wyolum/BADGEr/fabricate/photos/DSCN1586.JPG

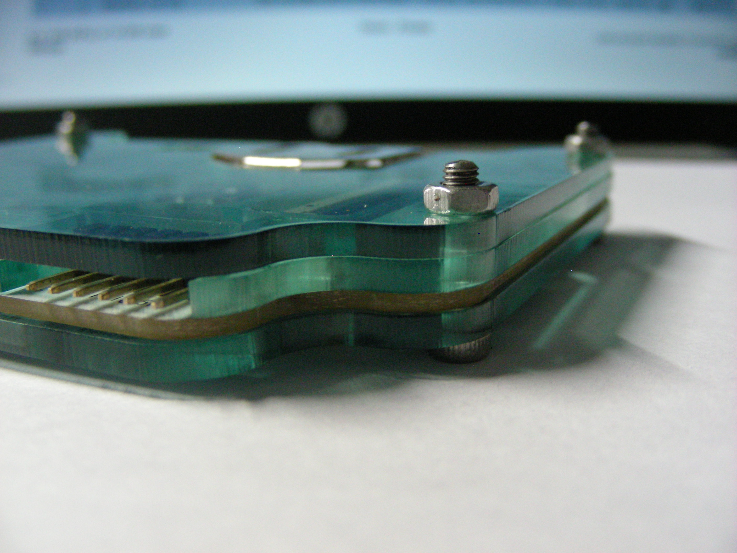
fabricate/photos/DSCN1586.JPG
