wyolum/BADGEr/fabricate/photos/DSCN1588.JPG

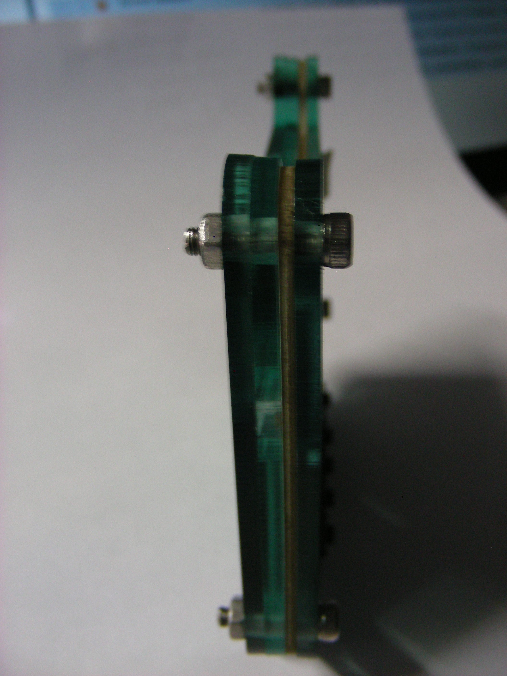
fabricate/photos/DSCN1588.JPG
