wyolum/BADGEr/README.md

BADGEr
======

EReader badge and shield
new version (v4.1) with minor mods to the front silk legend. No hardware changes from v4
