wyolum/BADGEr/Arduino/EPDV2/README.md

EPDV2
===

Electronic Paper Display libraries and examples
Updated for G2 COG driver
