wyolum/BADGEr/Kicad/BoM_BADGER_v41_Seeed.ods

Electronic Engineering BOM List
Product Name： OHSBadge
Version：V3.0
Issue Date：07/6/2013
Item No. (序号) | Reference Des (上件位置) | Qty (用量) | Catalog (分类） | Part_Description (规格描述) | Part_Value （元件值） | Part_Package （元件封装） | Manufacturers Name (使用厂牌名称) | Manufacturers Part No. (使用厂牌型号) | Distributors Name （供应商名称） | Distributors Part No. (供貨商型号) | Unit Price （单价） | Price Break To Use （价格分段的购买量） | Notes/Remark （备注）
Example（填写范例）
1 | BT1 | 1 | OTHER | RETAINER COIN CELL 24.5MM SMD | Coin Cell, Retainer, 24.5mm | CR2045_SMD | Keystone Electronics | 3008 | Digikey | 3008K-ND |  |  | http://www.digikey.com/product-detail/en/3008/3008K-ND/2137861
2 | BT2 | 1 | OTHER | BATTERY LITHIUM COIN 3V 24.5MM | Lithium, 3V, 650mAh, CR2450 | CR2450 | Panasonic - BSG | CR2450 | Digikey | P340-ND |  |  | http://www.digikey.com/product-detail/en/CR2450/P340-ND/447508
3 | C1,C11,C12,C14,C17,C18,C19,C20,C24,C25,C28,C30,C35 | 13 | Capacitor | 2.2u,16V, Y5V | CAP CER 2.2uF 16V Y5V 0805 | c_0805 | Samsung Electro-Mechanics America, Inc | CL21F225ZOFNNNE | Digikey | 1276-3016-1-ND |  |  | http://www.digikey.com/product-detail/en/CL21F225ZOFNNNE/1276-3016-1-ND/3891102
4 | C2,C3,C4,C5,C26,C27,C29,C31,C32,C33,C34 | 11 | Capacitor | 0.1u,16V, Y5V | CAP CER 0.1uF 16V Y5V 0805 | c_0805 | Kemet | C0805C104Z4VACTU | Digikey | 399-9159-1-ND |  |  | http://www.digikey.com/product-detail/en/C0805C104Z4VACTU/399-9159-1-ND/3522677
5 | C6,C9 | 2 | Capacitor | 22pF | CAP CER 22pF 16V 10% NP0 0603 | c_0805 | Kemet | C0603C220K4GACTU | Digikey | 399-9031-1-ND |  |  | http://www.digikey.com/product-detail/en/C0603C220K4GACTU/399-9031-1-ND/3522548
6 | C7 | 1 | Capacitor | 1u,16V, X7R | CAP CER 1uF 16V 10% X7R 0805 | c_0805 | Yageo | CC0805KKX7R7BB105 | Digikey | 311-1365-1-ND |  |  | http://www.digikey.com/product-detail/en/CC0805KKX7R7BB105/311-1365-1-ND/2103149
7 | C10 | 1 | Capacitor | 2.2u,10V, Y5V | CAP CER 2.2uF 10V Y5V 0805 | c_0805 | Murata Electronics North America | GRM21BF51A225ZA01L | Digikey | 490-1743-1-ND |  |  | http://www.digikey.com/product-detail/en/GRM21BF51A225ZA01L/490-1743-1-ND/587393
8 | C13 C15 C16 C22 C23 | 5 | Capacitor | 2.2u,25V, Y5V | CAP CER 2.2uF 25V Y5V 0805 | c_0805 | Samsung Electro-Mechanics America, Inc | CL21F225ZAFNNNE | Digikey | 1276-2874-1-ND |  |  | http://www.digikey.com/product-detail/en/CL21F225ZAFNNNE/1276-2874-1-ND/3890960
9 | C21 | 1 | Capacitor | 1u,10V, X7R | CAP CER 1uF 10V 20% X7R 0805 | c_0805 | Samsung Electro-Mechanics America, Inc | CL21B105MPFNNNE | Digikey | 1276-2933-1-ND |  |  | http://www.digikey.com/product-detail/en/CL21B105MPFNNNE/1276-2933-1-ND/3891019
10 | D1 | 1 | Diode | BAT54SW | DIODE SCHOTTKY 30V 200mA SC70 | SOT323 | NXP Semiconductors | BAT54SW,115 | Digikey | 568-1615-1-ND |  |  | http://www.digikey.com/product-detail/en/BAT54SW,115/568-1615-1-ND/763442
11 | D2 | 1 | Diode | DB2S20500L | DIODE SCHOTTKY 15V 200mA SSMINI2 | d_VMD2 | Panasonic Electronic Components - Semiconductor Products | DB2S20500L | Digikey | DB2S20500LCT-ND |  |  | http://www.digikey.com/product-detail/en/DB2S20500L/DB2S20500LCT-ND/2326091
12 | D3 | 1 | Diode | DEBUG | LED MINI TOPLED RED 630NM SMD | 2-SMD, J-Lead | OSRAM Opto Semiconductors Inc | LS M67K-J2L1-1-Z | Digikey | 475-2691-1-ND |  |  | http://www.digikey.com/product-detail/en/LS%20M67K-J2L1-1-Z/475-2691-1-ND/1938858
13 | J4 | 1 | Connector | ZIF-40-0.5 | CONN FPC/FFC 40POS .5MM HORZ SMD | ZIF-40-0.5-M | OSRAM Opto Semiconductors Inc | LG M67K-H1J2-24-Z | Digikey | 475-2730-1-ND |  |  | http://www.digikey.com/product-detail/en/LG%20M67K-H1J2-24-Z/475-2730-1-ND/1938897
14 | P3 | 1 | Connector | FTDI | CONN HEADER 6POS .100 R/A 30AU | Header_FTDI | FCI | 68016-106HLF | Digikey | 609-3313-ND |  |  | http://www.digikey.com/product-detail/en/68016-106HLF/609-3313-ND/1878482
15 | Q1 | 1 | Transistor | DMG2301U-7 | MOSFET P-CH 20V 2.5A SOT23 | SOT23-3 | Diodes Inc | DMG2301U-7 | Digikey | DMG2301U-7DICT-ND |  |  | http://www.digikey.com/product-detail/en/DMG2301U-7/DMG2301U-7DICT-ND/2179851
16 | Q2 Q4 Q5 Q6 | 4 | Transistor | 2N7002KW | MOSFET NCH 60V 310mA SOT323 | SOT323 | Fairchild Semiconductor | 2N7002KW | Digikey | 2N7002KWCT-ND |  |  | http://www.digikey.com/product-detail/en/2N7002KW/2N7002KWCT-ND/3907885
17 | Q3 Q7 | 2 | Transistor | BSS84W | MOSFET P-CH 50V 130mA SC70-3 | SOT323 | Diodes Inc | BSS84W-7-F | Digikey | BSS84W-FDICT-ND |  |  | http://www.digikey.com/product-detail/en/BSS84W-7-F/BSS84W-FDICT-ND/806569
18 | R1 | 1 | Resister | 33k, 5% | RES 33k OHM 1/8W 5% 0805 SMD | r_0805 | Yageo | RC0805JR-0733KL | Digikey | 311-33KARCT-ND |  |  | http://www.digikey.com/product-detail/en/RC0805JR-0733KL/311-33KARCT-ND/731261
19 | R4 R5 R6 R7 R8 R13 R16 | 7 | Resister | 10k, 5% | RES 10k OHM 1/8W 5% 0805 | r_0805 | Stackpole Electronics Inc | RMCF0805JT10K0 | Digikey | RMCF0805JT10K0CT-ND |  |  | http://www.digikey.com/product-detail/en/RMCF0805JT10K0/RMCF0805JT10K0CT-ND/1942577
20 | R9 | 1 | Resister | 2k, 5% | RES 2.0k OHM 1/8W 5% 0805 SMD | r_0805 | Yageo | RC0805JR-072KL | Digikey | 311-2.0KARCT-ND |  |  | http://www.digikey.com/product-detail/en/RC0805JR-072KL/311-2.0KARCT-ND/731215
21 | R10 R11 R12 | 3 | Resister | 100k, 5% | RES 100k OHM 1/8W 5% 0805 | r_0805 | Stackpole Electronics Inc | RMCF0805JT100K | Digikey | RMCF0805JT100KCT-ND |  |  | http://www.digikey.com/product-detail/en/RMCF0805JT100K/RMCF0805JT100KCT-ND/1942592
22 | R14 | 1 | Resister | 1k5, 5% | RES 1k5 OHM 1/8W 5% 0805 | r_0805 | Stackpole Electronics Inc | RMCF0805JT1K50 | Digikey | RMCF0805JT1K50CT-ND |  |  | http://www.digikey.com/product-detail/en/RMCF0805JT1K50/RMCF0805JT1K50CT-ND/1942560
23 | SD1 | 1 | Connector | Micro SD Card Socket | SD_CARD_MICRO | SD_Micro | ? | ? | seeed | ST-SD-006A |  |  | ?
24 | SW1 | 1 | OTHER | UP | SWITCH TACTILE SPST-NO 0.05A 12V | SW-PB | Diptronics Manufacturing Inc. | DTSM-62 | Seeed | --
25 | SW2 | 1 | OTHER | SEL | SWITCH TACTILE SPST-NO 0.05A 12V | SW-PB | Diptronics Manufacturing Inc. | DTSM-62 | Seeed | --
26 | SW3 | 1 | OTHER | DOWN | SWITCH TACTILE SPST-NO 0.05A 12V | SW-PB | Diptronics Manufacturing Inc. | DTSM-62 | Seeed | --
27 | SW4 | 1 | OTHER | RST | SWITCH TACTILE SPST-NO 0.05A 12V | SW-PB | Diptronics Manufacturing Inc. | DTSM-62 | Seeed | --
28 | SW5 | 1 | OTHER | MODE | SWITCH TACTILE SPST-NO 0.05A 12V | SW-PB | Diptronics Manufacturing Inc. | DTSM-62 | Seeed | --
 | SW6 | 1 | OTHER | SW_ON | Switch, Slide, SMD | SW_SLIDE_seeed | HC Brand (moralityele.com) | MS-12C02 | Seeed | --
29 | U1 | 1 | IC | MCP9700AT-E/TT | IC SENSOR THERMAL 2.3V SOT-23-3 | SOT23-3-Temp | Microchip Technology | MCP9700AT-E/TT | Digikey | MCP9700AT-E/TTCT-ND |  |  | http://www.digikey.com/product-detail/en/MCP9700AT-E%2FTT/MCP9700AT-E%2FTTCT-ND/3622388
30 | U2 | 1 | IC | ATMEGA328-AU-ND | IC MCU 8BIT 32KB FLASH 32TQFP | TQFP32 | Atmel | ATMEGA328-AU | Digikey | ATMEGA328-AU-ND |  |  | http://www.digikey.com/product-detail/en/ATMEGA328-AU/ATMEGA328-AU-ND/2271029
31 | U3 | 1 | IC | MCP1700T-33 | IC REG LDO 3.3V .25A SOT23-3 | SOT23 | Microchip Technology | MCP1700T-3302E/TT | Digikey | MCP1700T3302ETTCT-ND |  |  | http://www.digikey.com/product-detail/en/MCP1700T-3302E%2FTT/MCP1700T3302ETTCT-ND/652677
32 | U4 | 1 | IC | TXS0108 | IC 8BIT NON-INV TRANSLTR 20TSSOP | SO20L | Texas Instruments | TXS0108EPWR | Digikey | 296-23011-1-ND |  |  | http://www.digikey.com/product-detail/en/TXS0108EPWR/296-23011-1-ND/1775304
33 | U6 | 1 | IC | MCP1702T-50 | IC REG LDO 5V .25A SOT-23A | SOT23 | Microchip Technology | MCP1702T-5002E/CB | Digikey | MCP1702T-5002E/CBCT-ND |  |  | http://www.digikey.com/product-detail/en/MCP1702T-5002E%2FCB/MCP1702T-5002E%2FCBCT-ND/1979829
34 | X1 | 1 | OTHER | 8MHz | CRYSTAL 8.0MHz 8pF SMD | 2-SMD | NDK | NX8045GB-8.000000MHZ | Digikey | 644-1018-1-ND |  |  | http://www.digikey.com/product-detail/en/NX8045GB-8.000000MHZ/644-1018-1-ND/1128890
1. Recommended Distributor: Digi-Key, Mouser, Avnet Express, Farnell.
2. Catalog: Capacitor,Resister,Diode,Connector,Transistor,IC,PROTECTOR CATEGORY,OTHER
3. Required Fields: Item No, Reference Des, Qty, Catalog, Part_Value, Part Package
Optional Fields: Part_Description, Manufacturers Name, Manufacturers Part No, Distributors Name, Distributors Part No, Unit Cost, Price break to use, Notes/Remark
