wyolum/BADGEr/Kicad/BoM_BADGER_v41_Seeed_DNP.ods

Electronic Engineering BOM List
Product Name： OHSBadge_DNP List
Version：V3.0
Issue Date：23/5/2013
Item No. (序号) | Reference Des (上件位置) | Qty (用量) | Catalog (分类） | Part_Description (规格描述) | Part_Value （元件值） | Part_Package （元件封装） | Manufacturers Name (使用厂牌名称) | Manufacturers Part No. (使用厂牌型号) | Distributors Name （供应商名称） | Distributors Part No. (供貨商型号) | Unit Price （单价） | Price Break To Use （价格分段的购买量） | Notes/Remark （备注）
Example（填写范例）
1 | P5 | 1 | Connector | JST_3V3 | CONN HEADER PH SIDE 2POS 2MM SMD | CONN_JST-2_SMD | JST Sales America Inc | S2B-PH-SM4-TB(LF)(SN) | Digikey | 455-1749-1-ND |  |  | http://www.digikey.com/product-detail/en/S2B-PH-SM4-TB(LF)(SN)/455-1749-1-ND/926846
2 | P7 | 1 | Connector | UUSB_B | CONN USB MICRO B RECPT SMT R/A | USB_B_Micro | FCI | 10118193-0001LF | DigiKey | 609-4616-1-ND |  |  | http://www.digikey.com/product-detail/en/10118193-0001LF/609-4616-1-ND/2785380
3 | U5 | 1 | IC | BQ32000 | IC SRL REAL TIME CLOCK 8SOIC | 8-SOIC N | Texas Instruments | BQ32000DR | DigiKey | 296-24583-1-ND |  |  | http://www.digikey.com/product-detail/en/BQ32000DR/296-24583-1-ND/2078417
4 | X2 | 1 | OTHER | 32.768kHz | CRYSTAL 32.768KHZ 12.5PF THRU | Cylindrical Can, Radial | Abracon Corporation | AB38T-32.768KHZ | DigiKey | 535-9034-ND |  |  | http://www.digikey.com/scripts/dksearch/dksus.dll?vendor=0&keywords=535-9034-ND
1. Recommended Distributor: Digi-Key, Mouser, Avnet Express, Farnell.
2. Catalog: Capacitor,Resister,Diode,Connector,Transistor,IC,PROTECTOR CATEGORY,OTHER
3. Required Fields: Item No, Reference Des, Qty, Catalog, Part_Value, Part Package
Optional Fields: Part_Description, Manufacturers Name, Manufacturers Part No, Distributors Name, Distributors Part No, Unit Cost, Price break to use, Notes/Remark
