wyolum/BADGEr/Arduino/EPD/photobooth/person.csv

id | performance | confirmation code | ticket type | date of purchase | attendee last name | attendee first name | attendee email | phone | discount code used | company | website | email | company (attendee) | headshot | logo | position | sponsor | speaker | volunteer | organizer | demo | poster | press
1 | 2013-09-06 09:00 | AL-6904-3589-99A | Open Hardware Backer | 2013-06-10 18:41:00 | Alford | Kevin | kevin.alford@pixelflow.org |  |  |  |  |  | pixelflow, inc. |  |  | Attendee | Y | Y | Y | Y | Y | Y | Y
