wyolum/BADGEr/fabricate/3D_Case/BADGEr_case_compact_V3.stl

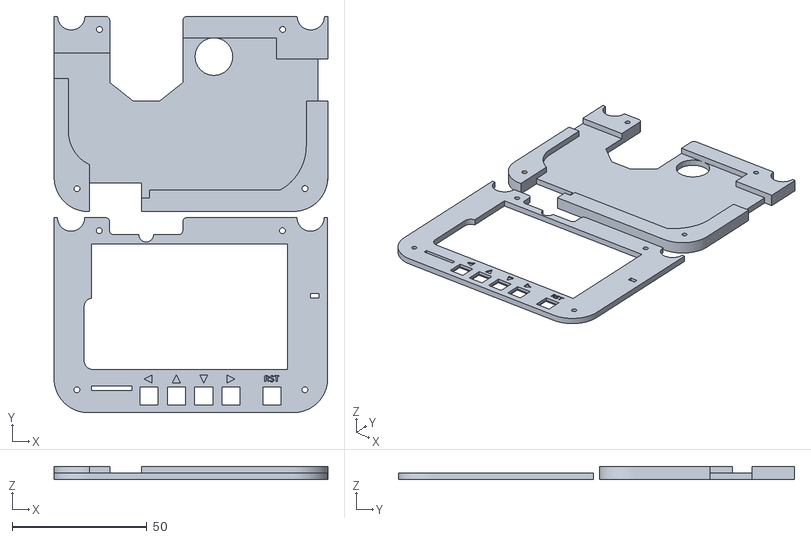
[picture p3: CAD file, 2014-04-12]
fabricate/3D_Case/BADGEr_case_compact_V3.stl
101.7 x 147.1 x 5.00
