wyolum/BADGEr/fabricate/laser_case/badger_case03.dxf

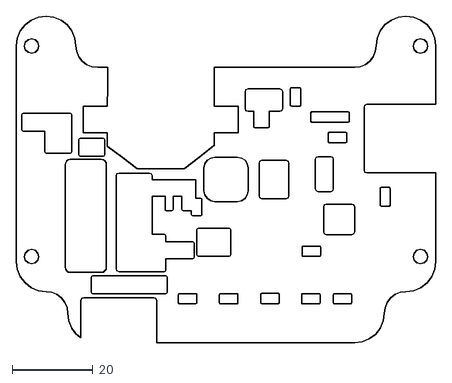
[picture p4: CAD file, 2015-11-06]
fabricate/laser_case/badger_case03.dxf
103.6 x 80.8
