wyolum/BADGEr/fabricate/laser_case/badger_case02.fcstd

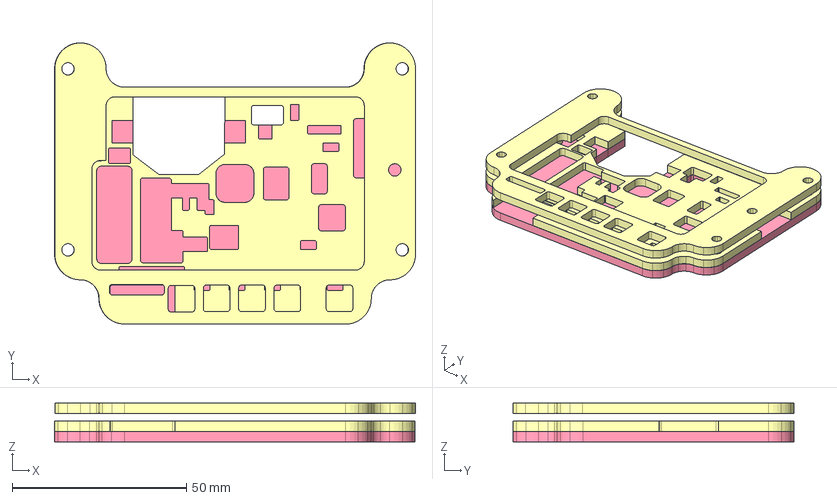
[picture p6: CAD file, 2015-11-06]
fabricate/laser_case/badger_case02.fcstd
103.7 x 80.8 x 11.2 mm
