wyolum/BADGEr/fabricate/laser_case/badger_case04.dxf

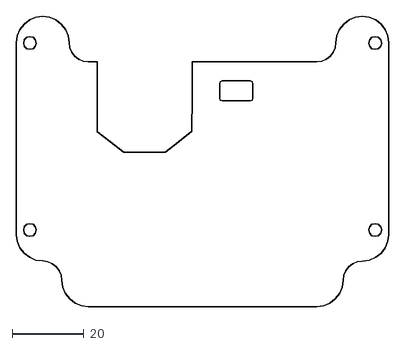
[picture p8: CAD file, 2015-11-06]
fabricate/laser_case/badger_case04.dxf
103.6 x 80.8
