wyolum/BADGEr/fabricate/laser_case/badger_case_v2_m.dxf

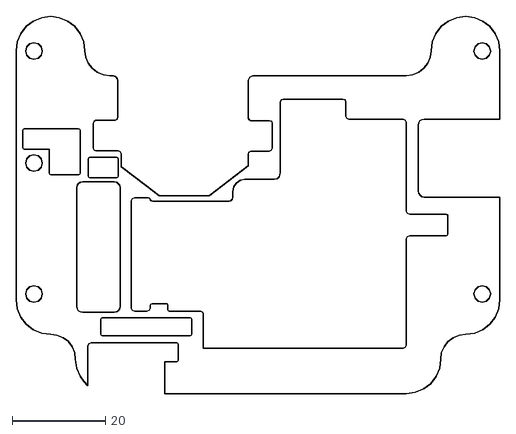
[picture p9: CAD file, 2015-11-06]
fabricate/laser_case/badger_case_v2_m.dxf
103.6 x 80.8
