wyolum/BADGEr/(list of files, cad)

Other CAD files:
fabricate/3D_Case/BADGEr_case_compact_V2.skp
fabricate/3D_Case/BADGEr_case_compact_V3.skp
fabricate/3D_Case/BADGEr_case_compact_Vdef.skp
fabricate/laser_case/badger_case02.dxf
