wyolum/BADGEr/fabricate/photos/DSCN1583.JPG

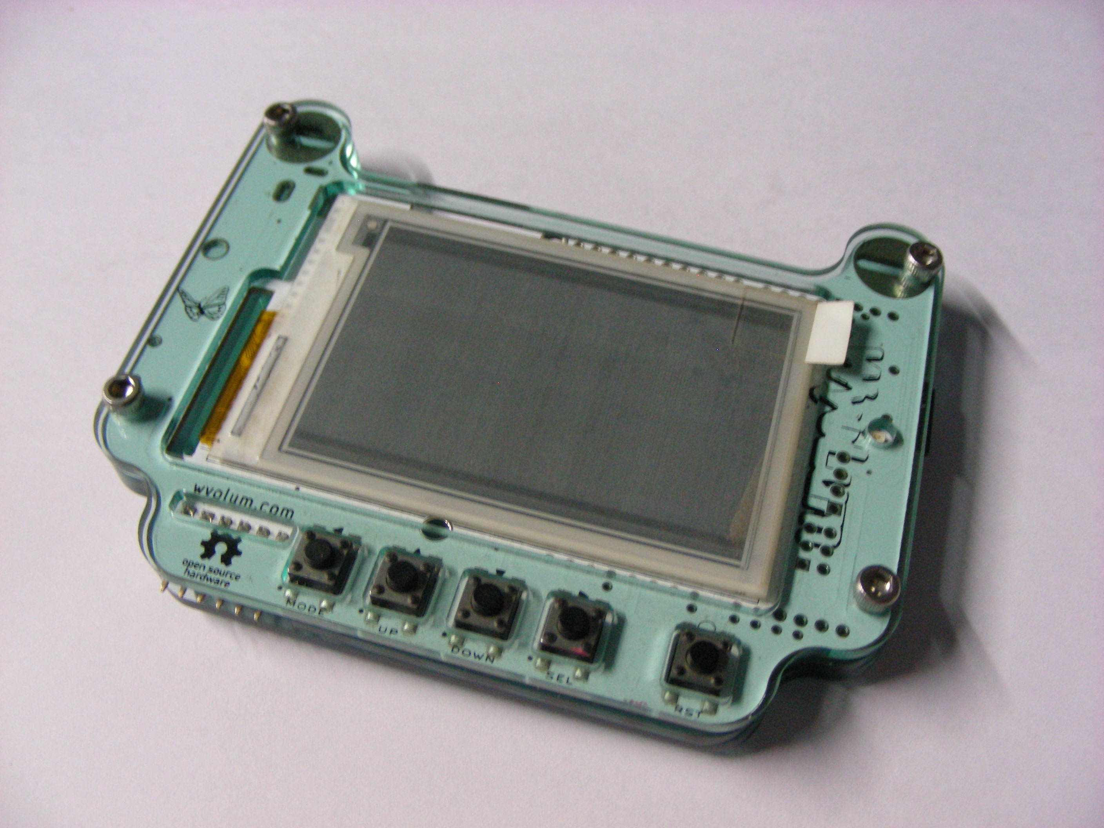
fabricate/photos/DSCN1583.JPG
