wyolum/BADGEr/fabricate/photos/DSCN1584.JPG

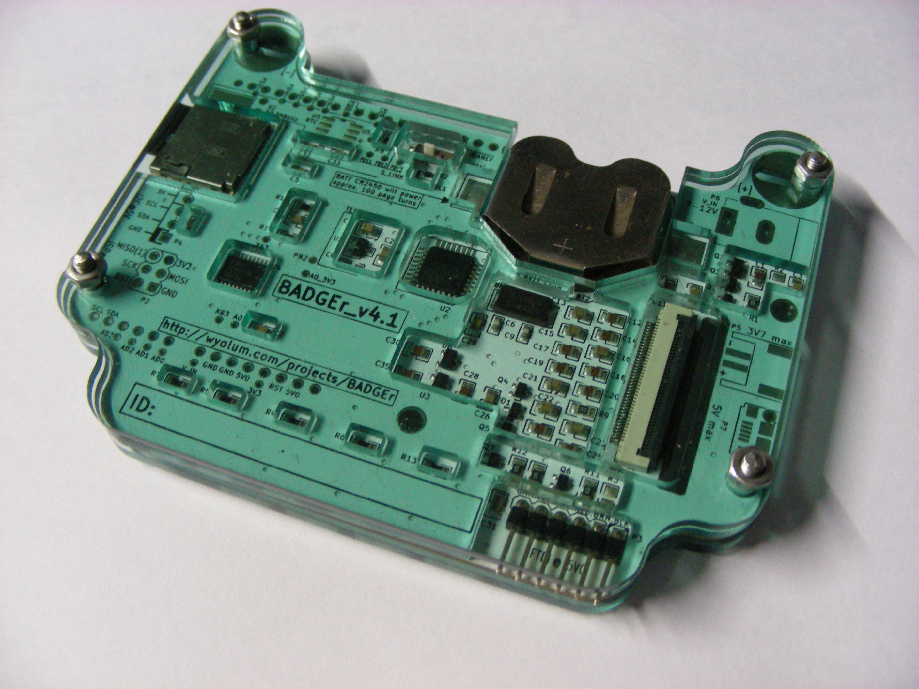
fabricate/photos/DSCN1584.JPG
