wyolum/BADGEr/fabricate/photos/DSCN1585.JPG

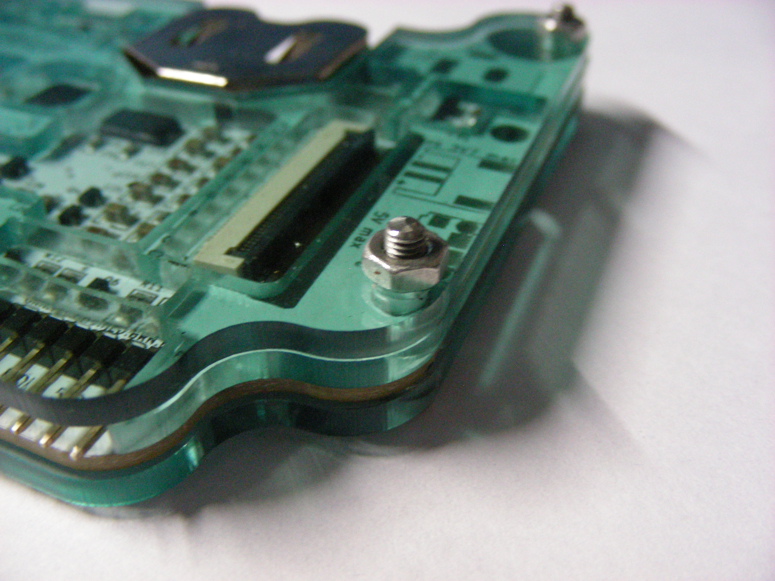
fabricate/photos/DSCN1585.JPG
