wyolum/BADGEr/fabricate/photos/DSCN1587.JPG

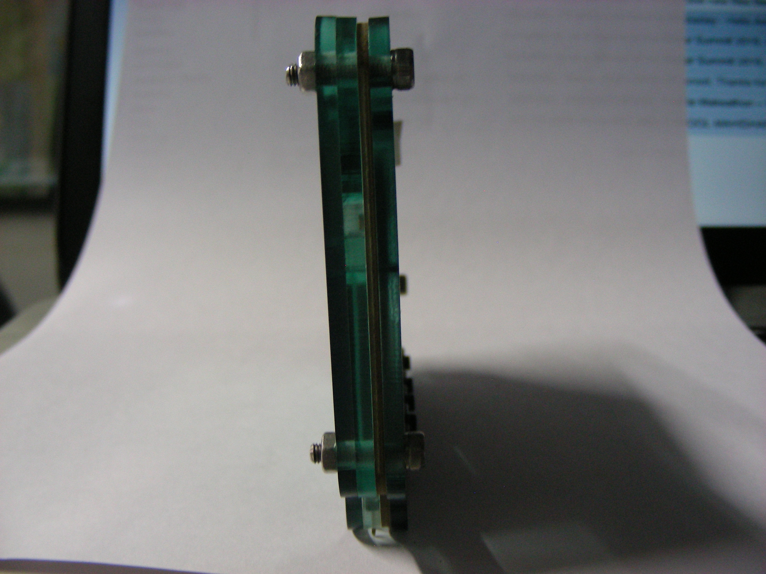
fabricate/photos/DSCN1587.JPG
