wyolum/BADGEr/fabricate/photos/DSCN1589.JPG

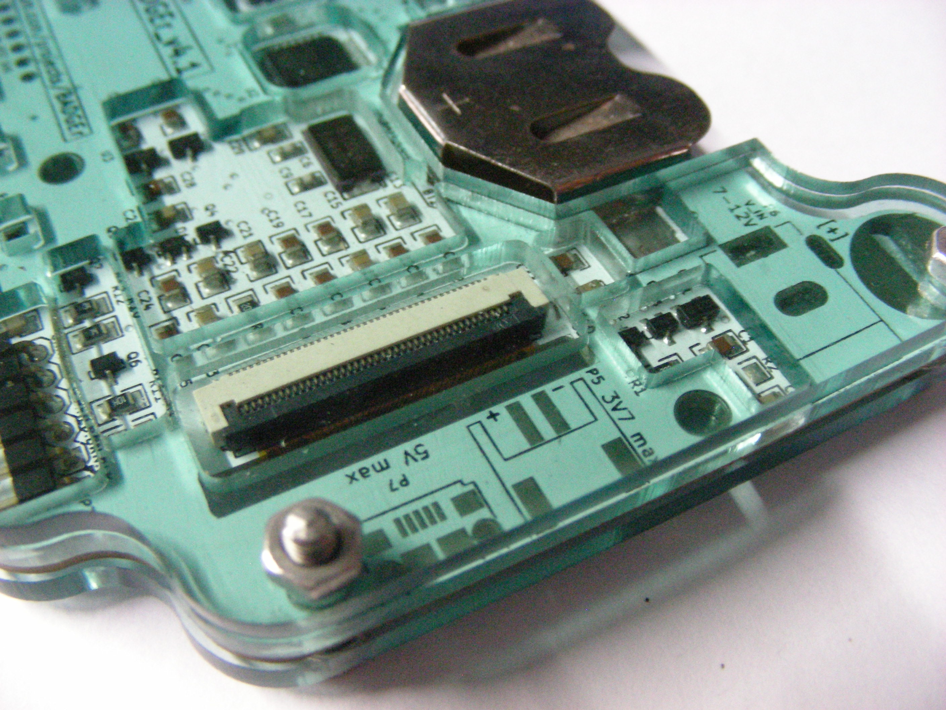
fabricate/photos/DSCN1589.JPG
