wyolum/BADGEr/Kicad/BADGER_v41.pdf

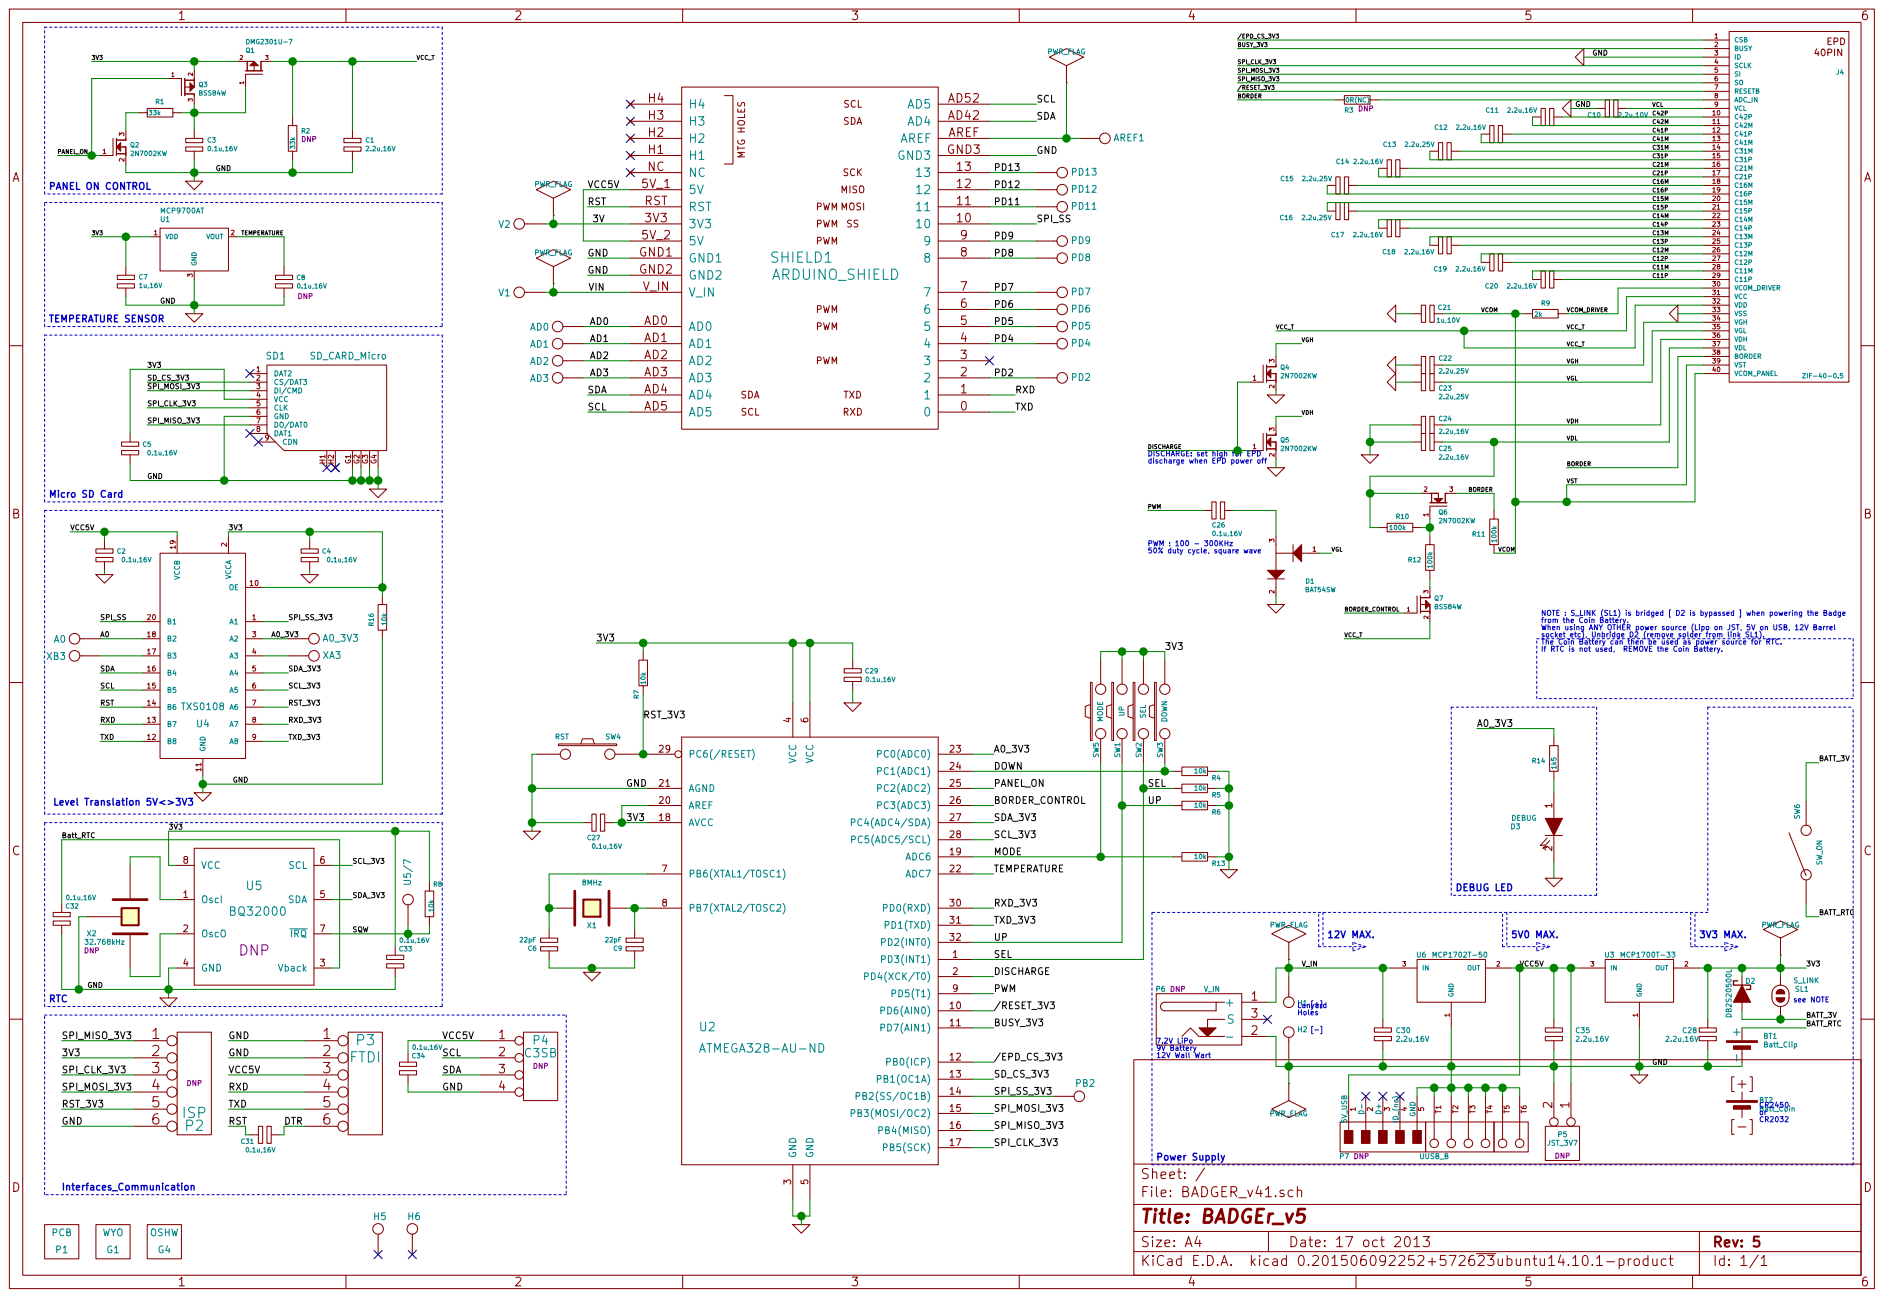
[picture p15: page 1]

discharge when EPD power off TEMPERATURE SENSOR

PWM : 100 - 300KHz 50% duty cycle, square wave DISCHARGE: set high for EPD

NOTE : S_LINK (SL1) is bridged [ D2 is bypassed ] when powering the Badge
from the Coin Battery. When using ANY OTHER power source (Lipo on JST, 5V on USB, 12V Barrel socket etc), Unbridge D2 (remove solder from link SL1). The Coin Battery can then be used as power source for RTC.

6 PB6(XTAL1/TOSC1) 7 PB7(XTAL2/TOSC2) 8 PD5(T1) 9 PD6(AIN0) 10 AREF 20 PD0(RXD) 30 PD7(AIN1) 11 AGND 21 PD1(TXD) 31 PB0(ICP) 12 ADC7 22 PD2(INT0) 32 PB1(OC1A) 13 PC0(ADC0) 23 PB2(SS/OC1B) 14 PC1(ADC1) 24 PB3(MOSI/OC2) 15 PC2(ADC2) 25 PB4(MISO) 16 PC3(ADC3) 26 PB5(SCK) 17 PC4(ADC4/SDA) 27 AVCC 18 PC5(ADC5/SCL) 28 ADC6 19 PC6(/RESET) 29 U2ATMEGA328-AU-ND
22pF GND
