wyolum/BADGEr/Kicad/BADGEr_v41_Gerber/BADGER_v41-B_SilkS.pdf

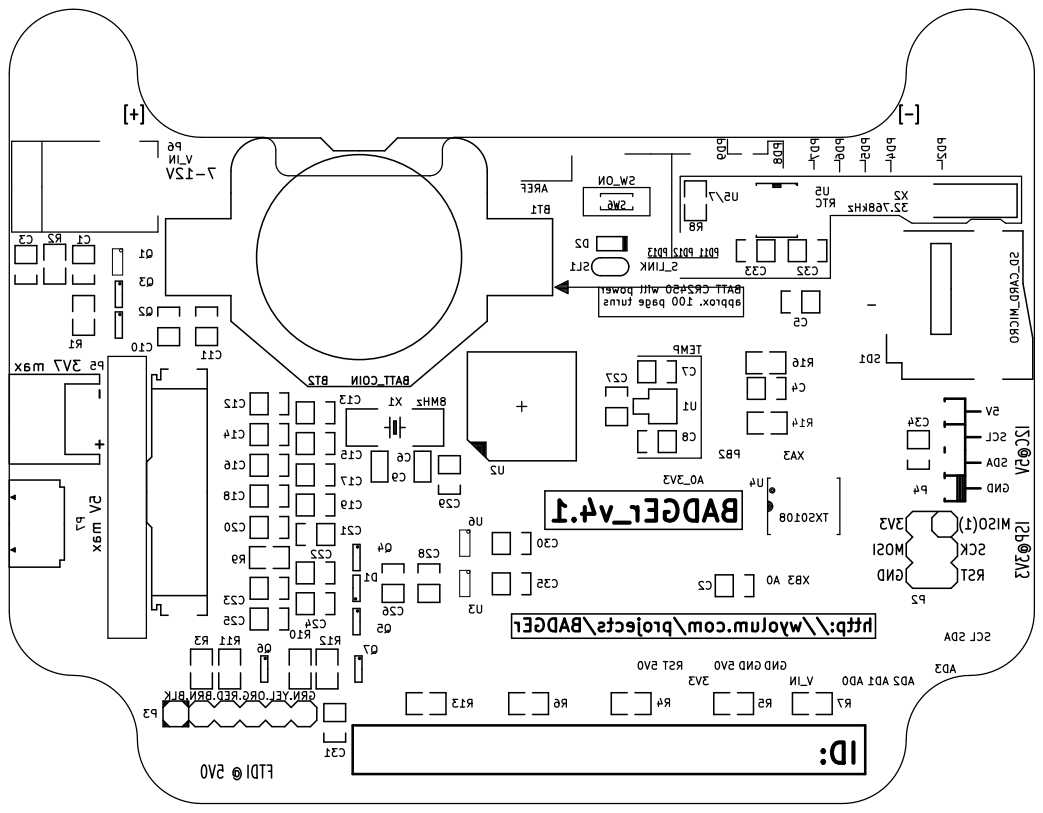
[picture p16: page 1]

5V0 RST 5V0 GND GND http://wyolum.com/projects/BADGErAREF

BT1 P2 3V3 MOSI GND MISO(1) SCK

5V Q5 Q2 Q4 Q6 D1 Q7 Q3 Q1 C5 C30 C20 C15 C18 C17 C10 C13 C14 C11 C19 C24 C16 C22 C7 C21 C23 C25 C12 C28 R1 R11 R12 R9 R3 R10 R16 R2 C26 C4 C2 C1 C8 C29 C3 C27 U1 R6 R4 R5 R7 XA3 A0_3V3 P3 FTDI GRN.YEL.ORG.RED.BRN.BLK

BATT CR2450 will power approx. 100 page turns BADGEr_v4.1
