wyolum/BADGEr/Kicad/BADGER_v41_PCB_S.pdf

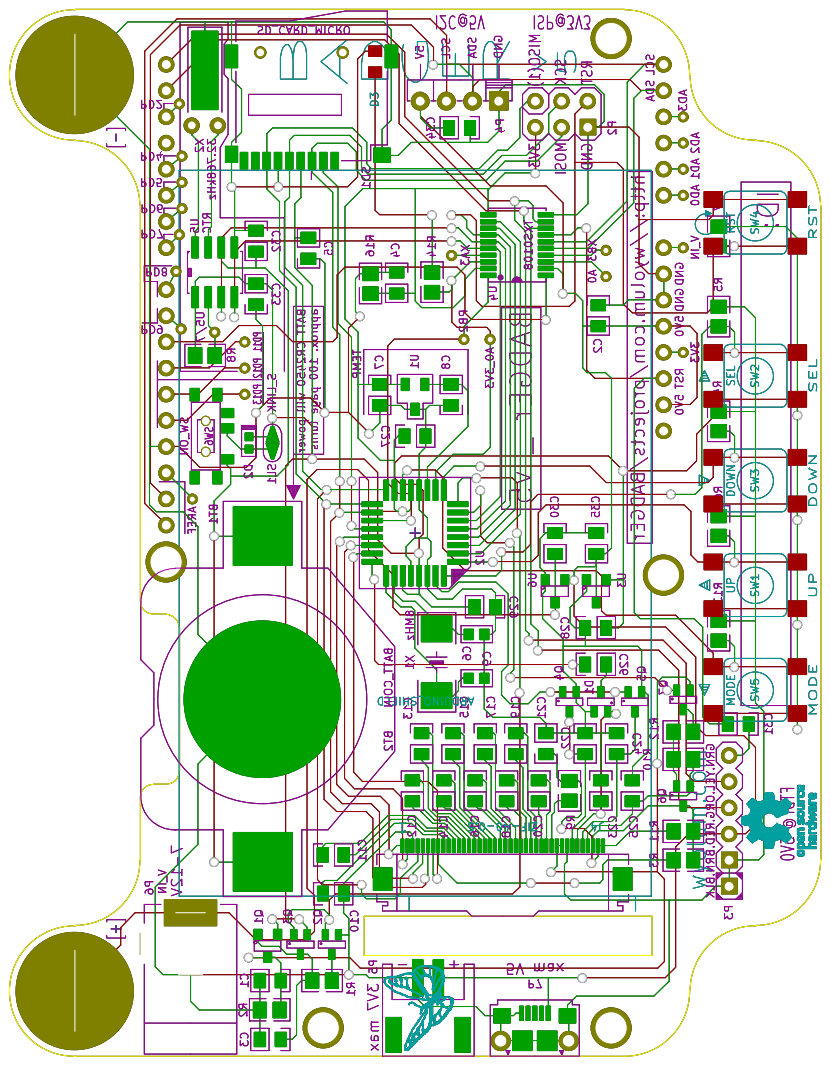
[picture p22: page 1]
