wyolum/BADGEr/Kicad/BADGEr_v41_Gerber/BADGER_v41-Dwgs_User.pdf

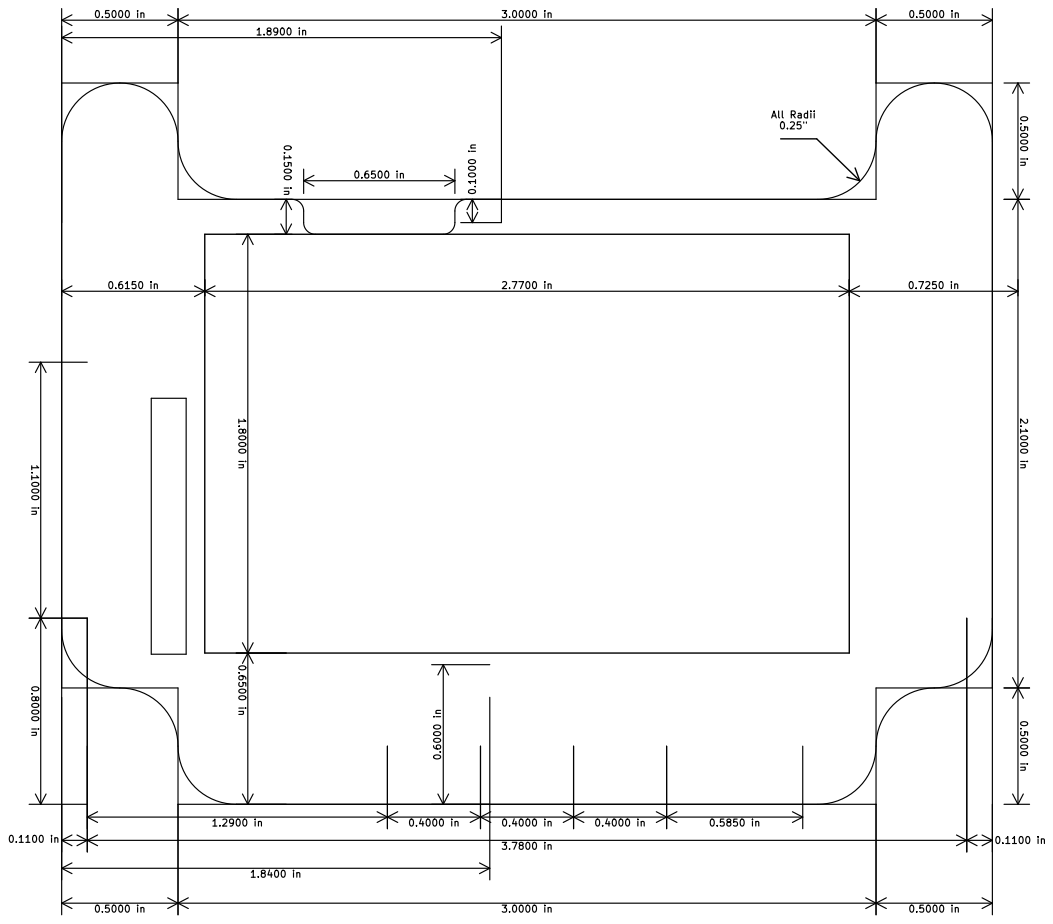
[picture p23: page 1]

All Radii 0.25" 0.6500 in 1.8000 in
