wyolum/BADGEr/Kicad/BADGEr_v41_Gerber/BADGER_v41-F_SilkS.pdf

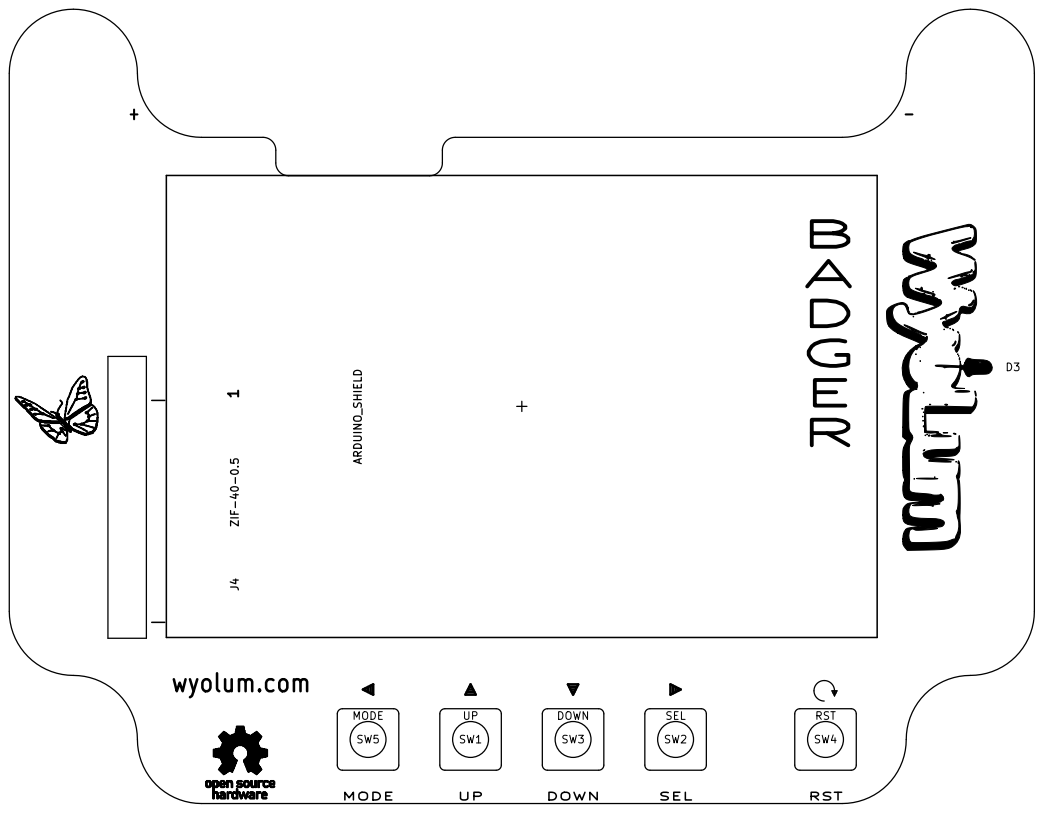
[picture p24: page 1]
