wyolum/BADGEr/Kicad/BADGER_v41.kicad_pcb

## KiCad design Kicad/BADGER_v41.kicad_pcb (2015-11-06)

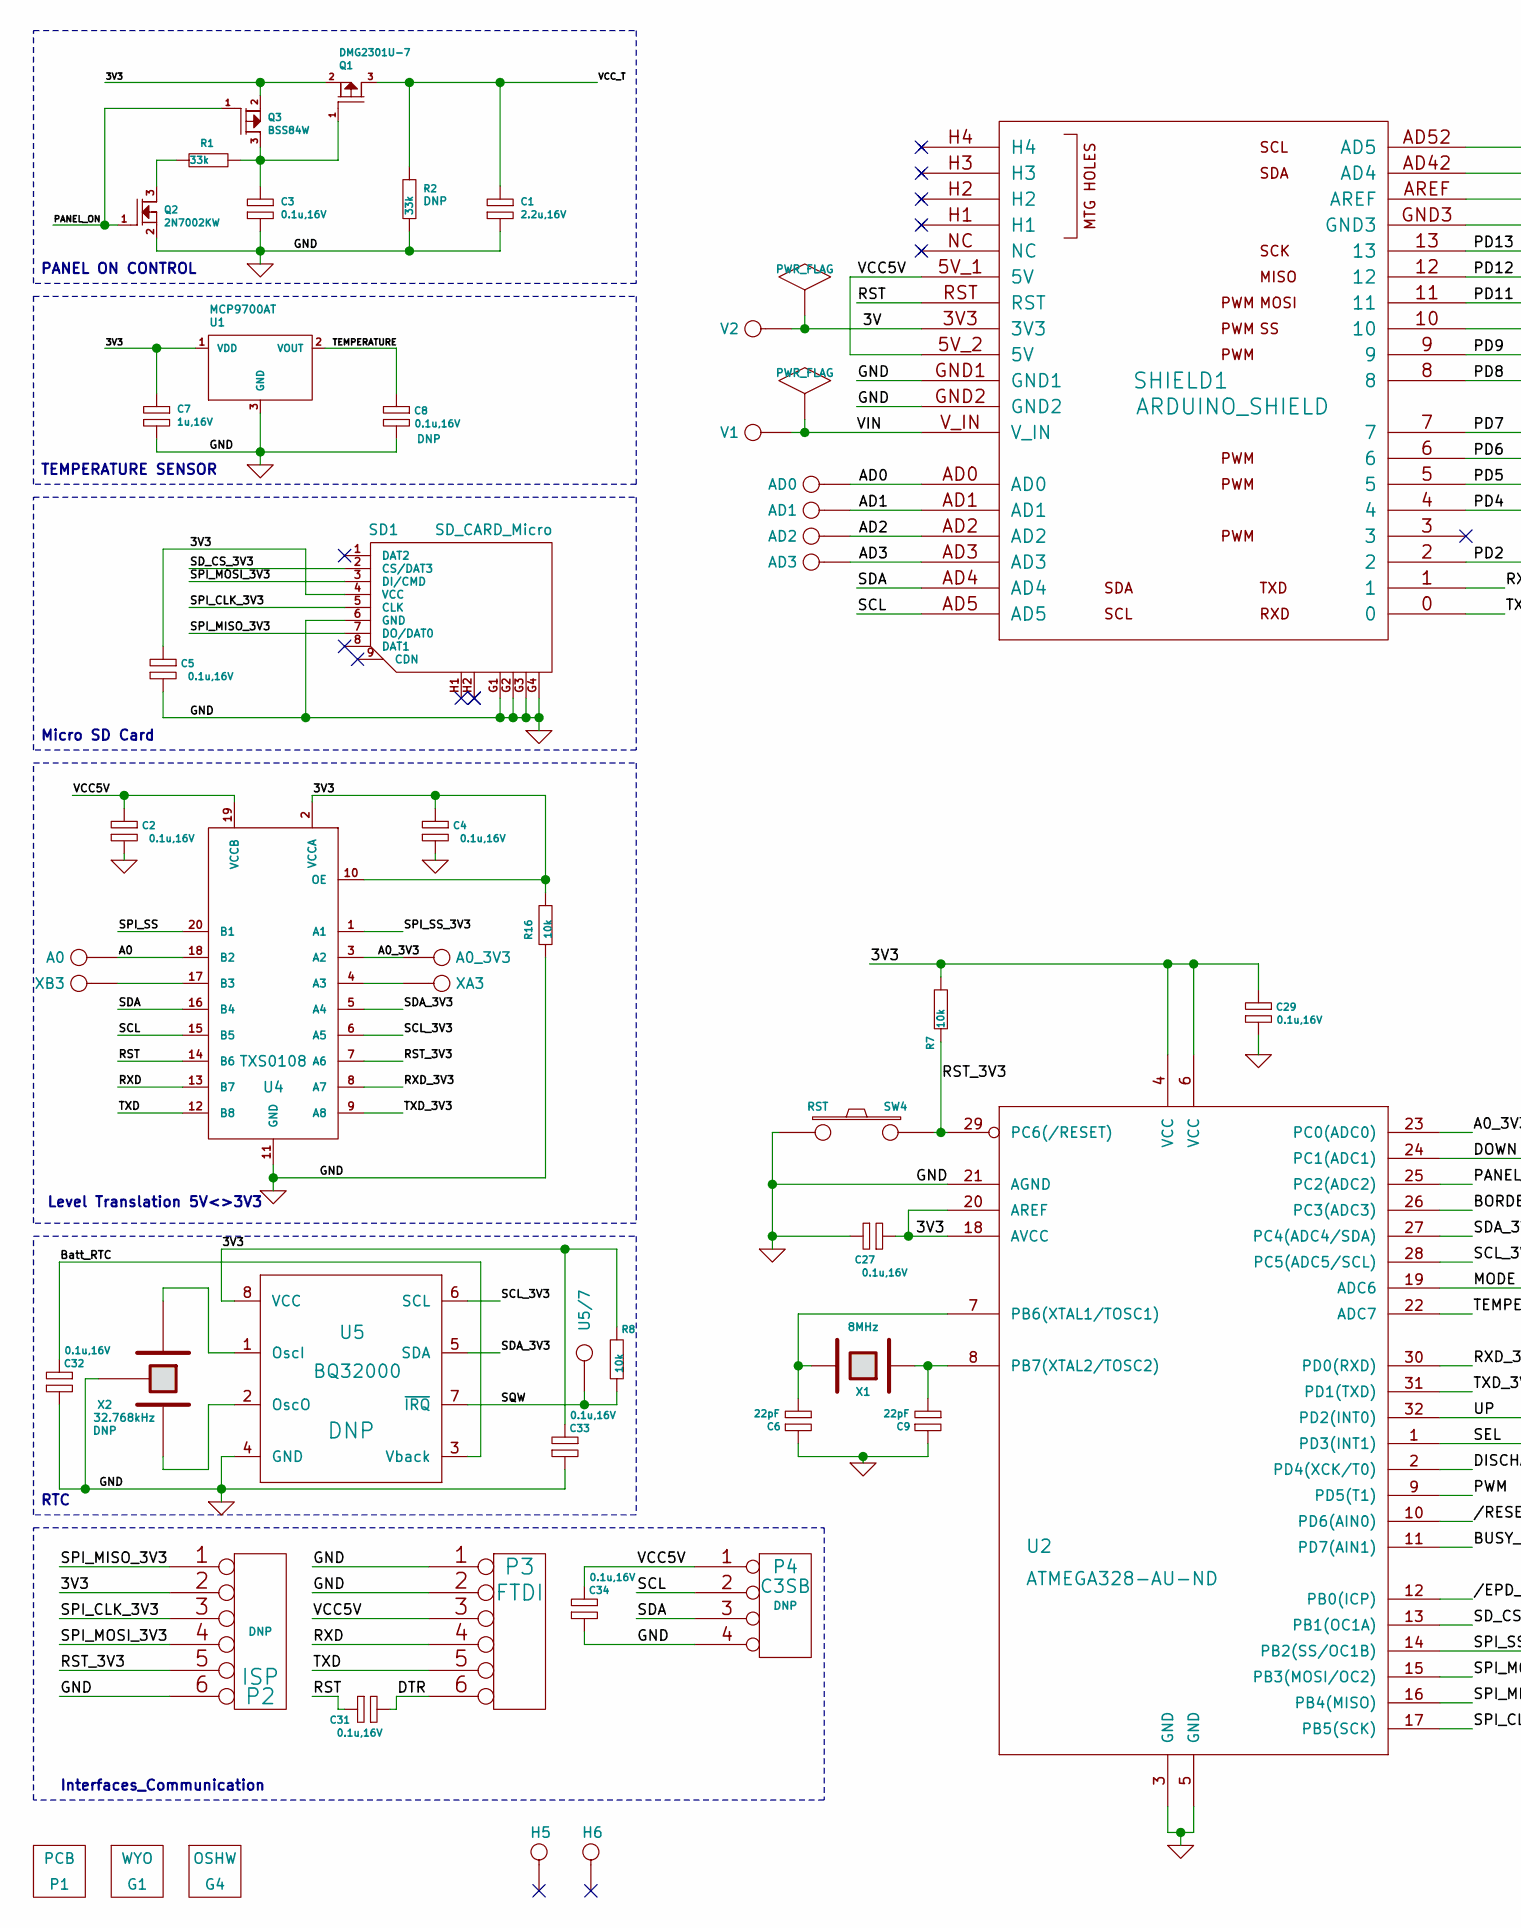
[picture p25: schematic BADGER_v41.sch, BADGEr_v5, part in row 1, column 1]

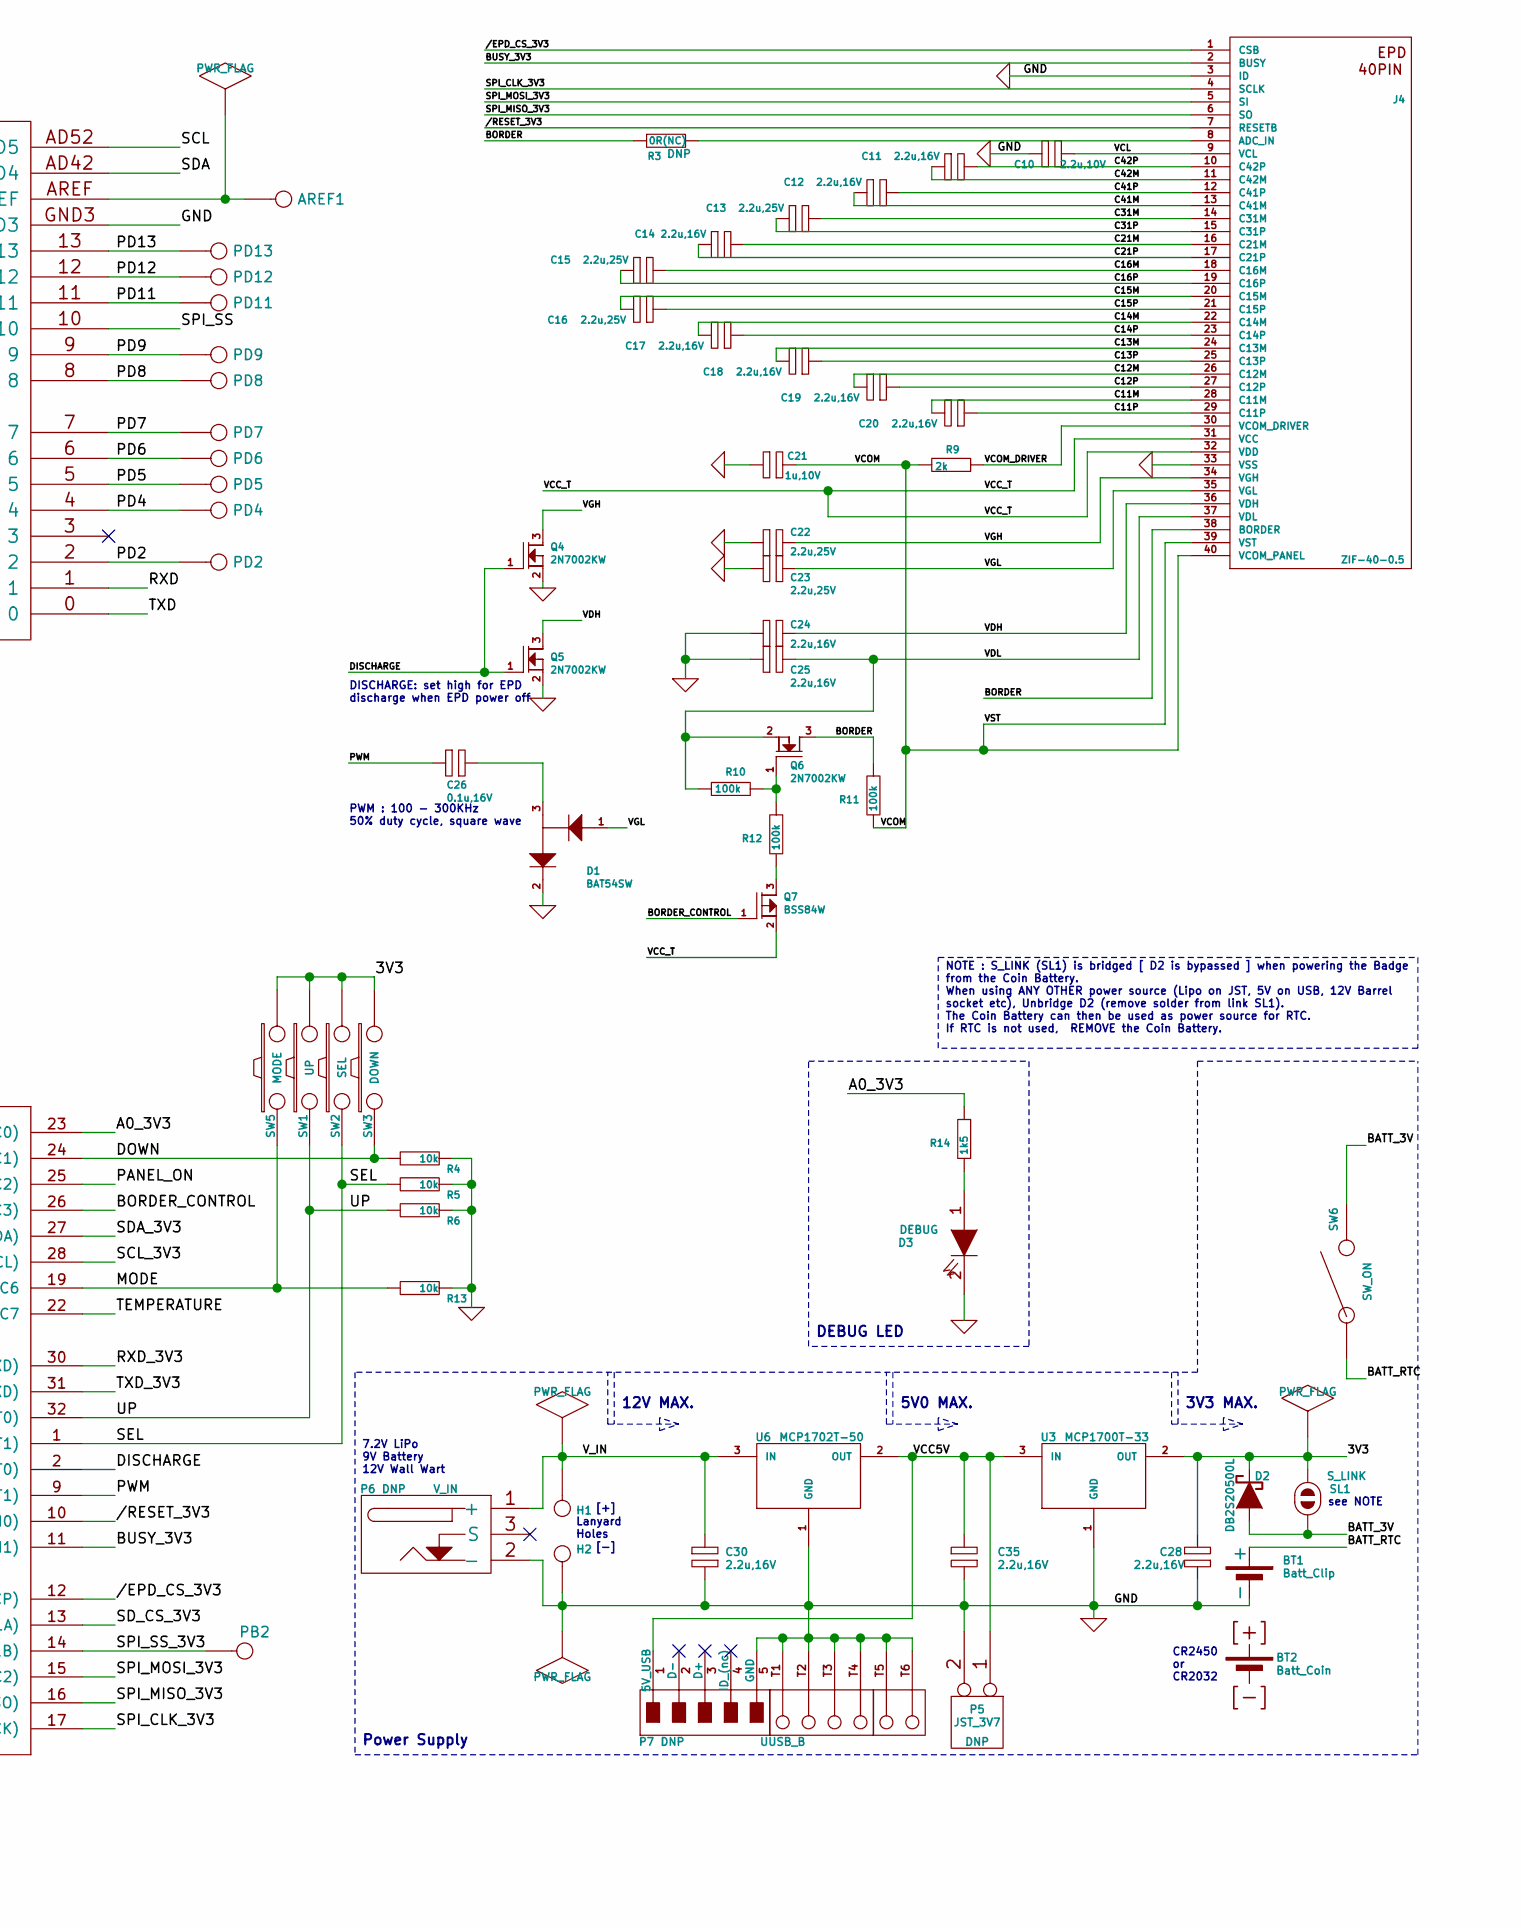
[picture p26: schematic BADGER_v41.sch, BADGEr_v5, part in row 1, column 2]

Parts:
A0, A0_3V3: IO
AD0, AD1, AD2, AD3: IO; Breakout
AREF1: IO; Breakout
BT1: Batt_Clip; CR2450_SMD
BT2: Batt_Coin; CR2032
C1, C11, C12, C14, C17, C18, C19, C20, C24, C25, C28, C30, C35: 2.2u,16V; c_0805
C2, C3, C4, C5, C8, C26, C27, C29, C31, C32, C33, C34: 0.1u,16V; c_0805
C6, C9: 22pF; c_0603
C7: 1u,16V; c_0805
C10: 2.2u,10V; c_0805
C13, C15, C16, C22, C23: 2.2u,25V; c_0805
C21: 1u,10V; c_0805
D1: BAT54SW; SOT323
D2: DB2S20500L; d_VMD2
D3: DEBUG; led_0805
G1: WYO; wyo_logo
G4: OSHW; OSHW_logo
H1, H2, H5, H6: I/O; vite_3mm
J4: ZIF-40-0.5; ZIF-40-0.5-M_seeed
P1: PCB
P2: ISP; Header_ISP
P3: FTDI; Header_FTDI
P4: C3SB; pin_strip_4-90
P5: JST_3V7; CONN_JST-2_SMD
P6: V_IN; JACK_ALIM
P7: UUSB_B; USB_B_Micro
PB2: IO
PD2, PD4, PD5, PD6, PD7, PD8, PD9, PD11, PD12, PD13: IO; Breakout
Q1: DMG2301U-7; SOT23
Q2, Q4, Q5, Q6: 2N7002KW; SOT323
Q3, Q7: BSS84W; SOT323
R1, R2: 33k; r_0805
R3: 0R(NC); r_0805
R4, R5, R6, R7, R8, R13, R16: 10k; r_0805
R9: 2k; r_0805
R10, R11, R12: 100k; r_0805
R14: 1k5; r_0805
SD1: SD_CARD_Micro; SD_Micro_seeed
SHIELD1: ARDUINO_SHIELD; ARDUINO_SHIELD_040pins
SL1: S_LINK; ShortLink
SW1: UP; SW_SMD
SW2: SEL; SW_SMD
SW3: DOWN; SW_SMD
SW4: RST; SW_SMD
SW5: MODE; SW_SMD
SW6: SW_ON; SW_SLIDE_seeed
U1: MCP9700AT; SOT23-3-Temp
U2: ATMEGA328-AU-ND; TQFP32
U3: MCP1700T-33; SOT23
U4: TXS0108; TXS0108EPWR
U5: BQ32000; SO8E
U5/7: IO
U6: MCP1702T-50; SOT23
V1, V2: IO; Breakout
X1: 8MHz; Xtal_SMD
X2: 32.768kHz; XTAL_3
XA3: IO
XB3: IO

Connections:
/3V: SHIELD1.3V3, V2.1
/3V3: C4.1, C5.1, C7.2, C27.2, C28.1, C29.1, C33.1, D2.2 (K), P2.2, Q1.2, Q3.2, R7.2, R8.2, R16.2, SD1.4 (VCC), SL1.2, SW1.2, SW2.2, SW3.2, SW5.2, U1.1 (VDD), U2.4 (VCC), U2.6 (VCC), U2.18 (AVCC), U2.20 (AREF), U3.2 (OUT), U4.2 (VCCA), U4.10 (OE), U5.8 (VCC)
//EPD_CS_3V3: J4.1 (CSB), U2.12 (PB0(ICP))
//RESET_3V3: J4.7 (RESETB), U2.10 (PD6(AIN0))
/A0: A0.1, U4.18 (B2)
/A0_3V3: A0_3V3.1, R14.1, U2.23 (PC0(ADC0)), U4.3 (A2)
/AD0: AD0.1, SHIELD1.AD0
/AD1: AD1.1, SHIELD1.AD1
/AD2: AD2.1, SHIELD1.AD2
/AD3: AD3.1, SHIELD1.AD3
/BATT_3V: D2.1 (A), SL1.1, SW6.2
/BATT_RTC: BT1.+, C32.1, SW6.1, U5.3 (Vback)
/BORDER: J4.38 (BORDER), Q6.3, R3.2, R11.1
/BORDER_CONTROL: Q7.1, U2.26 (PC3(ADC3))
/BUSY_3V3: J4.2 (BUSY), U2.11 (PD7(AIN1))
/C11M: C20.1, J4.28 (C11M)
/C11P: C20.2, J4.29 (C11P)
/C12M: C19.1, J4.26 (C12M)
/C12P: C19.2, J4.27 (C12P)
/C13M: C18.1, J4.24 (C13M)
/C13P: C18.2, J4.25 (C13P)
/C14M: C17.1, J4.22 (C14M)
/C14P: C17.2, J4.23 (C14P)
/C15M: C16.1, J4.20 (C15M)
/C15P: C16.2, J4.21 (C15P)
/C16M: C15.1, J4.18 (C16M)
/C16P: C15.2, J4.19 (C16P)
/C21M: C14.1, J4.16 (C21M)
/C21P: C14.2, J4.17 (C21P)
/C31M: C13.1, J4.14 (C31M)
/C31P: C13.2, J4.15 (C31P)
/C41M: C12.2, J4.13 (C41M)
/C41P: C12.1, J4.12 (C41P)
/C42M: C11.2, J4.11 (C42M)
/C42P: C11.1, J4.10 (C42P)
/DISCHARGE: Q4.1, Q5.1, U2.2 (PD4(XCK/T0))
/DOWN: R4.2, SW3.1, U2.24 (PC1(ADC1))
/DTR: C31.2, P3.6
/MODE: R13.2, SW5.1, U2.19 (ADC6)
/PANEL_ON: Q2.1, Q3.1, U2.25 (PC2(ADC2))
/PD2: PD2.1, SHIELD1.2
/PD4: PD4.1, SHIELD1.4
/PD5: PD5.1, SHIELD1.5
/PD6: PD6.1, SHIELD1.6
/PD7: PD7.1, SHIELD1.7
/PD8: PD8.1, SHIELD1.8
/PD9: PD9.1, SHIELD1.9
/PD11: PD11.1, SHIELD1.11
/PD12: PD12.1, SHIELD1.12
/PD13: PD13.1, SHIELD1.13
/PWM: C26.2, U2.9 (PD5(T1))
/RST: C31.1, SHIELD1.RST, U4.14 (B6)
/RST_3V3: P2.5, R7.1, SW4.2, U2.29 (PC6(/RESET)), U4.7 (A6)
/RXD: P3.4, SHIELD1.1, U4.13 (B7)
/RXD_3V3: U2.30 (PD0(RXD)), U4.8 (A7)
/SCL: P4.2, SHIELD1.AD5, SHIELD1.AD52 (AD5), U4.15 (B5)
/SCL_3V3: U2.28 (PC5(ADC5/SCL)), U4.6 (A5), U5.6 (SCL)
/SDA: P4.3, SHIELD1.AD4, SHIELD1.AD42 (AD4), U4.16 (B4)
/SDA_3V3: U2.27 (PC4(ADC4/SDA)), U4.5 (A4), U5.5 (SDA)
/SD_CS_3V3: SD1.2 (CS/DAT3), U2.13 (PB1(OC1A))
/SEL: R5.2, SW2.1, U2.1 (PD3(INT1))
/SPI_CLK_3V3: J4.4 (SCLK), P2.3, SD1.5 (CLK), U2.17 (PB5(SCK))
/SPI_MISO_3V3: J4.6 (SO), P2.1, SD1.7 (DO/DAT0), U2.16 (PB4(MISO))
/SPI_MOSI_3V3: J4.5 (SI), P2.4, SD1.3 (DI/CMD), U2.15 (PB3(MOSI/OC2))
/SPI_SS: SHIELD1.10, U4.20 (B1)
/SPI_SS_3V3: PB2.1, U2.14 (PB2(SS/OC1B)), U4.1 (A1)
/SQW: R8.1, U5.7 (~IRQ), U5/7.1
/TEMPERATURE: C8.1, U1.2 (VOUT), U2.22 (ADC7)
/TXD: P3.5, SHIELD1.0, U4.12 (B8)
/TXD_3V3: U2.31 (PD1(TXD)), U4.9 (A8)
/UP: R6.2, SW1.1, U2.32 (PD2(INT0))
/VCC5V: C2.1, C34.1, C35.1, P3.3, P4.1, P5.1, P7.1 (5V_USB), SHIELD1.5V_1 (5V), SHIELD1.5V_2 (5V), U3.3 (IN), U4.19 (VCCB), U6.2 (OUT)
/VCC_T: C1.2, J4.31 (VCC), J4.32 (VDD), Q1.3, Q7.2, R2.1
/VCL: C10.2, J4.9 (VCL)
/VCOM: C21.2, J4.39 (VST), J4.40 (VCOM_PANEL), R9.2, R11.2
/VCOM_DRIVER: J4.30 (VCOM_DRIVER), R9.1
/VDH: C24.1, J4.36 (VDH), Q5.3
/VDL: C25.1, J4.37 (VDL), Q6.2, R10.2
/VGH: C22.1, J4.34 (VGH), Q4.3
/VGL: C23.1, D1.1, J4.35 (VGL)
/VIN: SHIELD1.V_IN, V1.1
/V_IN: C30.1, H1.1, P6.1 (+), U6.3 (IN)
GND: BT1.-, C1.1, C2.2, C3.1, C4.2, C5.2, C6.1, C7.1, C8.2, C9.1, C10.1, C21.1, C22.2, C23.2, C24.2, C25.2, C27.1, C28.2, C29.2, C30.2, C32.2, C33.2, C34.2, C35.2, D1.2, D3.2 (K), H2.1, J4.3 (ID), J4.33 (VSS), P2.6, P3.1, P3.2, P4.4, P5.2, P6.2 (-), P7.5 (GND), P7.T1, P7.T2, P7.T3, P7.T4, P7.T5, P7.T6, Q2.2, Q4.2, Q5.2, R2.2, R4.1, R5.1, R6.1, R13.1, R16.1, SD1.6 (GND), SD1.G1, SD1.G2, SD1.G3, SD1.G4, SHIELD1.GND1, SHIELD1.GND2, SHIELD1.GND3, SW4.1, U1.3 (GND), U2.3 (GND), U2.5 (GND), U2.21 (AGND), U3.1 (GND), U4.11 (GND), U5.4 (GND), U6.1 (GND), X2.3
unnamed: C9.2, U2.8 (PB7(XTAL2/TOSC2)), X1.1
unnamed: C6.2, U2.7 (PB6(XTAL1/TOSC1)), X1.2
unnamed: Q2.3, R1.1
unnamed: U4.17 (B3), XB3.1
unnamed: C3.2, Q1.1, Q3.3, R1.2
unnamed: U4.4 (A3), XA3.1
unnamed: AREF1.1, SHIELD1.AREF
unnamed: D3.1 (A), R14.2
unnamed: U5.2 (OscO), X2.2
unnamed: U5.1 (OscI), X2.1
unnamed: C26.1, D1.3
unnamed: J4.8 (ADC_IN), R3.1
unnamed: Q7.3, R12.2
unnamed: Q6.1, R10.1, R12.1

Notes on the sheet:
PWM : 100 - 300KHz 50% duty cycle, square wave
DISCHARGE: set high for EPD discharge when EPD power off
TEMPERATURE SENSOR
Micro SD Card
PANEL ON CONTROL
Level Translation 5V<>3V3
RTC
Power Supply
Interfaces_Communication
[+]
[-]
3V3 MAX.
5V0 MAX.
12V MAX.
CR2450 or CR2032
7.2V LiPo 9V Battery 12V Wall Wart
Lanyard Holes
NOTE : S_LINK (SL1) is bridged [ D2 is bypassed ] when powering the Badge from the Coin Battery. When using ANY OTHER power source (Lipo on JST, 5V on USB, 12V Barrel socket etc), Unbridge D2 (remove solder from link SL1). The Coin Battery can then be used as power source for RTC. If RTC is not use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
see NOTE
DEBUG LED

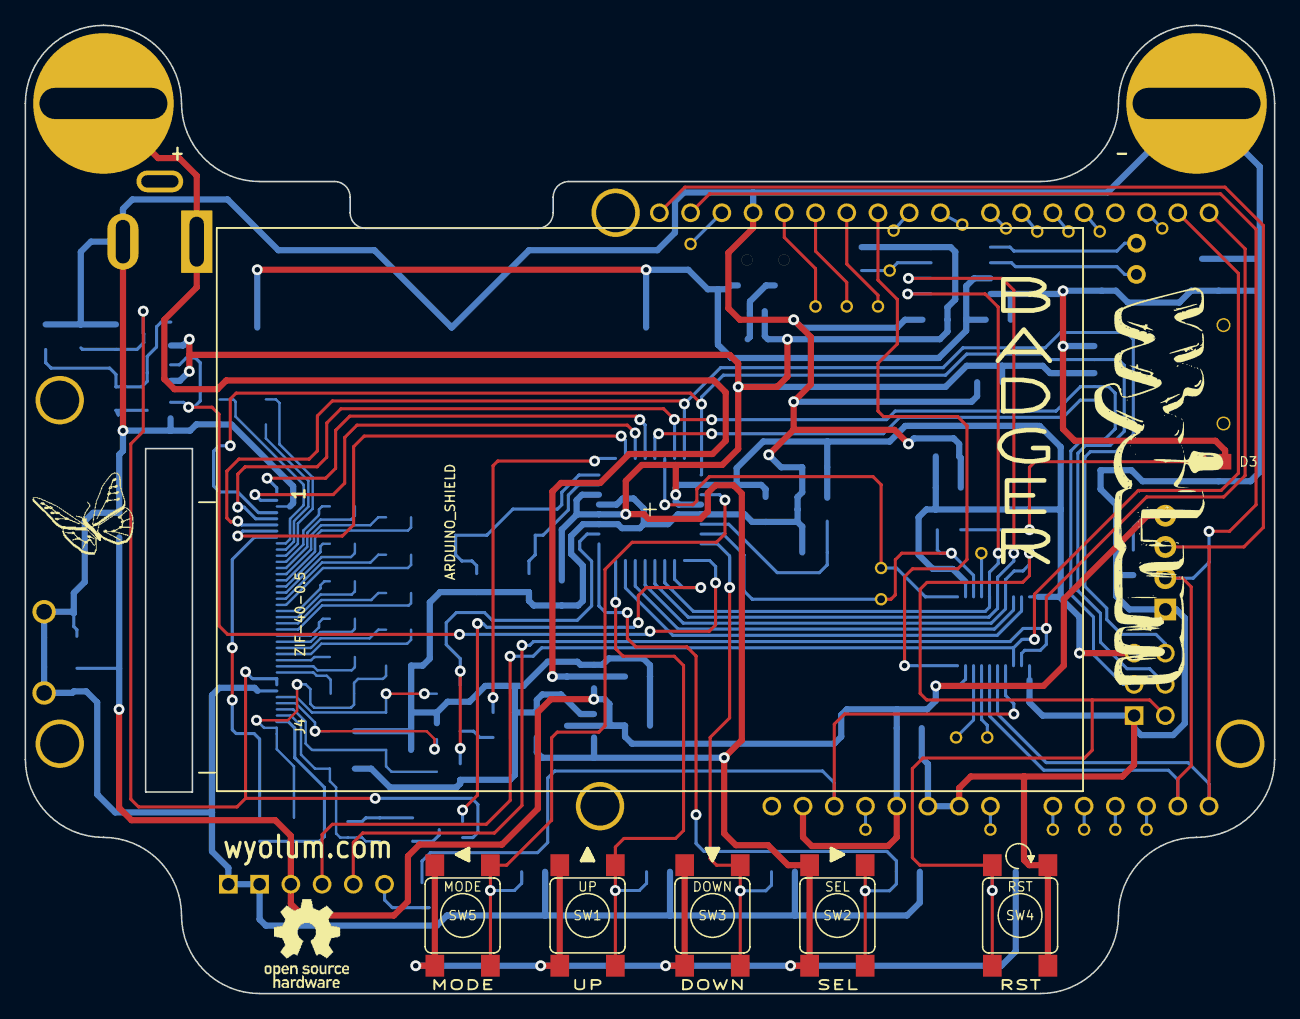
[picture p27: board BADGER_v41.kicad_pcb from above]

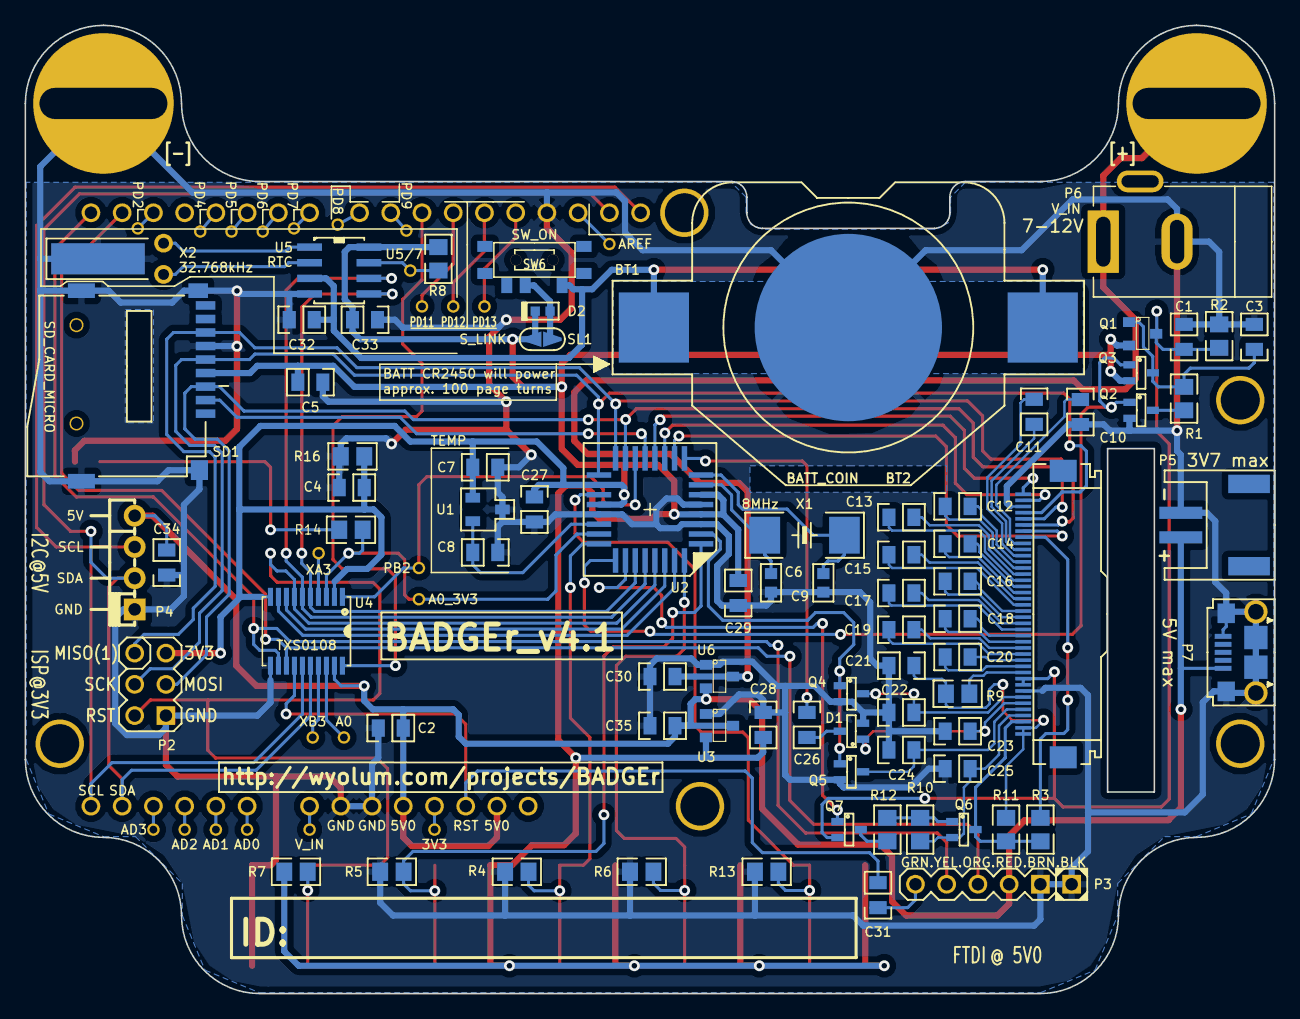
[picture p28: board BADGER_v41.kicad_pcb from below]

Board: 2 copper layers, 101.6 x 78.7 mm, 116 parts (101 on the bottom side), 97 nets.
