wyolum/BADGEr/(commit log)

2013-10-17 Initial commit for v5 of BADGEr
    [BADGER_v5.kicad_pcb, BADGER_v5.sch, BoM_BADGER_v5_Seeed.ods, BoM_BADGER_v5_Seeed.xls, BoM_BADGER_v5_Seeed_DNP.ods, BoM_BADGER_v5_Seeed_DNP.xls, BoM_BADGER_v5_pcb.csv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]
2013-10-18 changed to v4.1 and added Logo
    [BADGER_v5.kicad_pcb]
2013-10-19 modified WyoLum logo on front legend
    [BADGER_v5.kicad_pcb]
2013-10-20 changed ver no. from v5 to v4.1
    [BADGER_v5.kicad_pcb, BADGER_v5.sch, BoM_BADGER_v5_Seeed.ods, BoM_BADGER_v5_Seeed.xls, BoM_BADGER_v5_Seeed_DNP.ods, BoM_BADGER_v5_Seeed_DNP.xls, BoM_BADGER_v5_pcb.csv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]
2013-10-21 created Gerber and PDF files for production of ver 4.1
2014-04-12 moved Kicad files to folder. Added 3D case files
    [BADGER_v41.kicad_pcb, BADGER_v41.sch, BADGEr_case_compact_V2.skp, BADGEr_case_compact_V3.skp, BADGEr_case_compact_V3.stl, BADGEr_case_compact_Vdef.skp, BoM_BADGER_v41_Seeed.ods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]
2014-06-20 BADGEr added Silk legend and Dimensions PDF Files
    [BADGER_v41.kicad_pcb]
2015-06-11 minor mods, no need to regenerate gerbers
    [BADGER_v41.kicad_pcb, BADGER_v41.sch, BADGER_v41_BoM_sch.csv, BADGEr_case_compact_V2.skp, BADGEr_case_compact_V3.skp, BADGEr_case_compact_V3.stl, BADGEr_case_compact_Vdef.skp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]
2015-08-28 checkin updated Arduino library and examples
2015-11-06 added laser cut enclosure files and photos
    [BADGER_v41.kicad_pcb, BADGEr_case_compact_V2.skp, BADGEr_case_compact_V3.skp, BADGEr_case_compact_V3.stl, BADGEr_case_compact_Vdef.skp, badger_case02.dxf, badger_case02.fcstd, badger_case03.dxf]
2015-11-11 Add in EPDV2 (G2 COG driver) files
    [person.csv]
2017-06-01 fix fading by sending 0 on spi bus, capitalization error on include
